wadetb/tire-sensor/README.md

# Tire Sensor

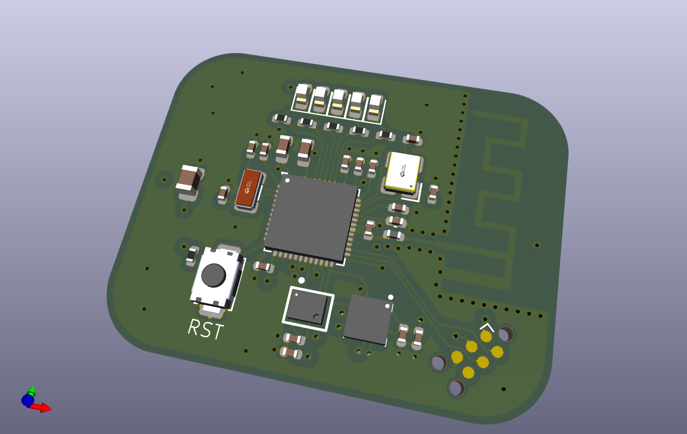
[picture p1: tire_sensor_oshpark/tire_sensor_oshpark_front.png]
Tire Sensor Front

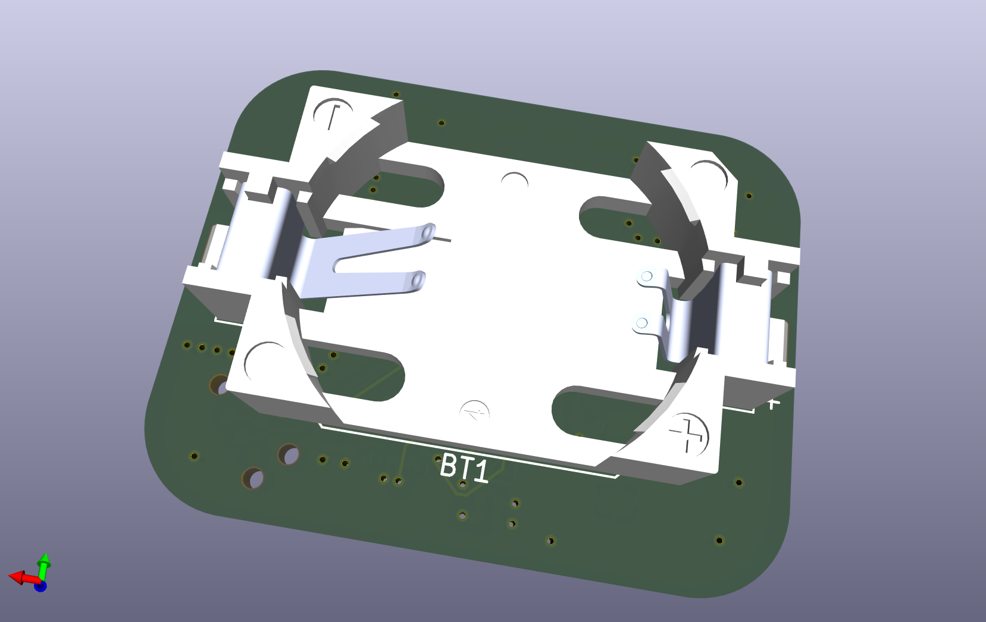
[picture p2: tire_sensor_oshpark/tire_sensor_oshpark_back.png]
Tire Sensor Back
