wadetb/tire-sensor/reference/nRF52832-QFAx Reference Layout 1_1/Bill of Materials/nRF52832-QFAA/nrf52832_qfaa_nfc_bom.xls

Bill of material
PCB: | nRF52832-QFAA Reference Layout (NFC)
Version: | 1.1
Designator | Value | Description | Footprint Doc
C1, C2, C11, C12, C13, C14 | 12pF | Capacitor, NP0, ±2% | 0402
C3 | 0.8pF | Capacitor, NP0, ±5% | 0402
C4, C5, C8 | 100nF | Capacitor, X7R, ±10% | 0402
C6 | N.C. | Not mounted | 0402
C7 | 100pF | Capacitor, NP0, ±5% | 0402
C9 | 4.7µF | Capacitor, X5R, ±10% | 0603
C10 | 1.0µF | Capacitor, X7R, ±10% | 0603
C_tune1, C_tune2 | TBD | Capacitor, NP0, ±5% | 0402
L1 | 3.9nH | High frequency chip inductor ±5% | 0402
L2 | 10µH | Chip inductor, IDC,min = 50 mA, ±20% | 0603
L3 | 15nH | High frequency chip inductor ±10% | 0402
U1 | nRF52832-QFAA | Multi-protocol Bluetooth Low Energy, ANT and 2.4GHz proprietary system-on-chip | QFN-48
X1 | 32MHz | XTAL SMD 2016, 32MHz, Cl=8pF, Total Tol: ±40ppm | XTAL_2016
X2 | 32.768kHz | XTAL SMD 3215, 32.768kHz, Cl=9pF, Total Tol: ±50ppm | XTAL_3215
