wadetb/tire-sensor/tire_sensor_oshpark/models/BAT-HLD-013-SMT-TR.step

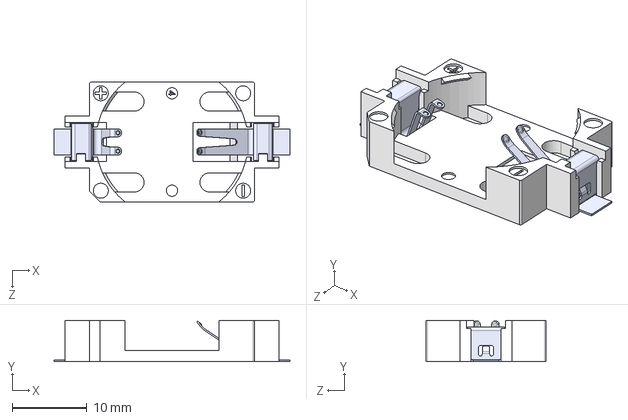
[picture p3: CAD file, 2025-07-16]
tire_sensor_oshpark/models/BAT-HLD-013-SMT-TR.step
31.5 x 5.50 x 16.0 mm
