wadetb/tire-sensor/tire_sensor_oshpark/models/LIS3DHTR.step

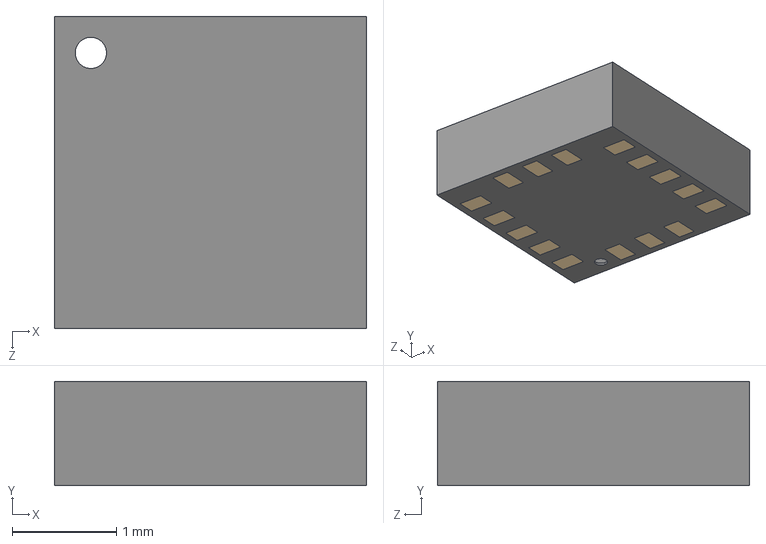
[picture p4: CAD file, 2025-07-16]
tire_sensor_oshpark/models/LIS3DHTR.step
3.00 x 1.00 x 3.00 mm
