wadetb/tire-sensor/tire_sensor_oshpark/models/DPS368XTSA1.step

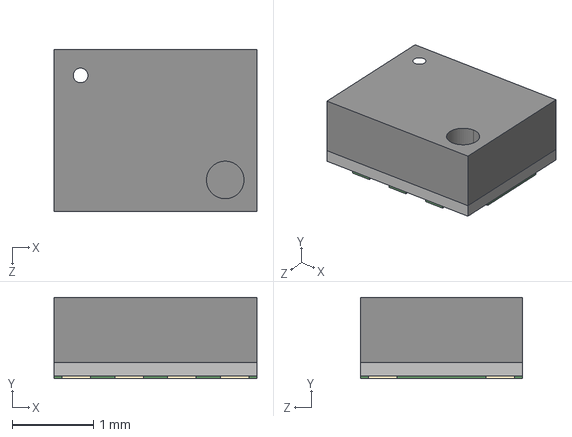
[picture p5: CAD file, 2025-07-16]
tire_sensor_oshpark/models/DPS368XTSA1.step
2.50 x 1.00 x 2.00 mm
