wadetb/tire-sensor/tire_sensor_oshpark/models/NRF52832-QFAA-R.step

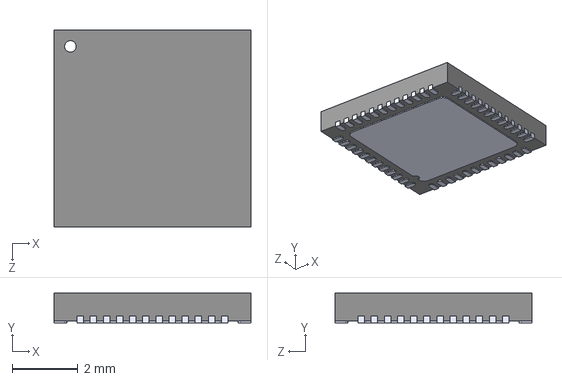
[picture p6: CAD file, 2025-07-16]
tire_sensor_oshpark/models/NRF52832-QFAA-R.step
6.00 x 0.9 x 6.00 mm
