wadetb/tire-sensor/(list of files, drawings)

Other design files:
reference/nRF52832-QFAx Reference Layout 1_1/Altium Designer files/nRF52832-QFAA/nrf52832_qfaa.PrjPCB
reference/nRF52832-QFAx Reference Layout 1_1/Altium Designer files/nRF52832-QFAA/nrf52832_qfaa.SchDoc
reference/nRF52832-QFAx Reference Layout 1_1/Altium Designer files/nRF52832-QFAA/nrf52832_qfaa_dcdc.PrjPCB
reference/nRF52832-QFAx Reference Layout 1_1/Altium Designer files/nRF52832-QFAA/nrf52832_qfaa_dcdc.SchDoc
reference/nRF52832-QFAx Reference Layout 1_1/Altium Designer files/nRF52832-QFAA/nrf52832_qfaa_nfc.PrjPCB
reference/nRF52832-QFAx Reference Layout 1_1/Altium Designer files/nRF52832-QFAA/nrf52832_qfaa_nfc.SchDoc
reference/nRF52832-QFAx Reference Layout 1_1/Altium Designer files/nRF52832-QFAA/nrf52832_qfax.PcbDoc
reference/nRF52832-QFAx Reference Layout 1_1/Altium Designer files/nRF52832-QFAA/nrf52832_qfax_dcdc.PcbDoc
reference/nRF52832-QFAx Reference Layout 1_1/Altium Designer files/nRF52832-QFAA/nrf52832_qfax_nfc.PcbDoc
reference/nRF52832-QFAx Reference Layout 1_1/Altium Designer files/nRF52832-QFAB/nrf52832_qfab.PrjPCB
reference/nRF52832-QFAx Reference Layout 1_1/Altium Designer files/nRF52832-QFAB/nrf52832_qfab.SchDoc
reference/nRF52832-QFAx Reference Layout 1_1/Altium Designer files/nRF52832-QFAB/nrf52832_qfab_dcdc.PrjPCB
reference/nRF52832-QFAx Reference Layout 1_1/Altium Designer files/nRF52832-QFAB/nrf52832_qfab_dcdc.SchDoc
reference/nRF52832-QFAx Reference Layout 1_1/Altium Designer files/nRF52832-QFAB/nrf52832_qfab_nfc.PrjPCB
reference/nRF52832-QFAx Reference Layout 1_1/Altium Designer files/nRF52832-QFAB/nrf52832_qfab_nfc.SchDoc
reference/nRF52832-QFAx Reference Layout 1_1/Altium Designer files/nRF52832-QFAB/nrf52832_qfax.PcbDoc
reference/nRF52832-QFAx Reference Layout 1_1/Altium Designer files/nRF52832-QFAB/nrf52832_qfax_dcdc.PcbDoc
reference/nRF52832-QFAx Reference Layout 1_1/Altium Designer files/nRF52832-QFAB/nrf52832_qfax_nfc.PcbDoc
