wadetb/tire-sensor/tire_sensor_jlcpcb/tire_sensor_jlcpcb.kicad_pcb

## KiCad design tire_sensor_jlcpcb/tire_sensor_jlcpcb.kicad_pcb (2026-01-19)

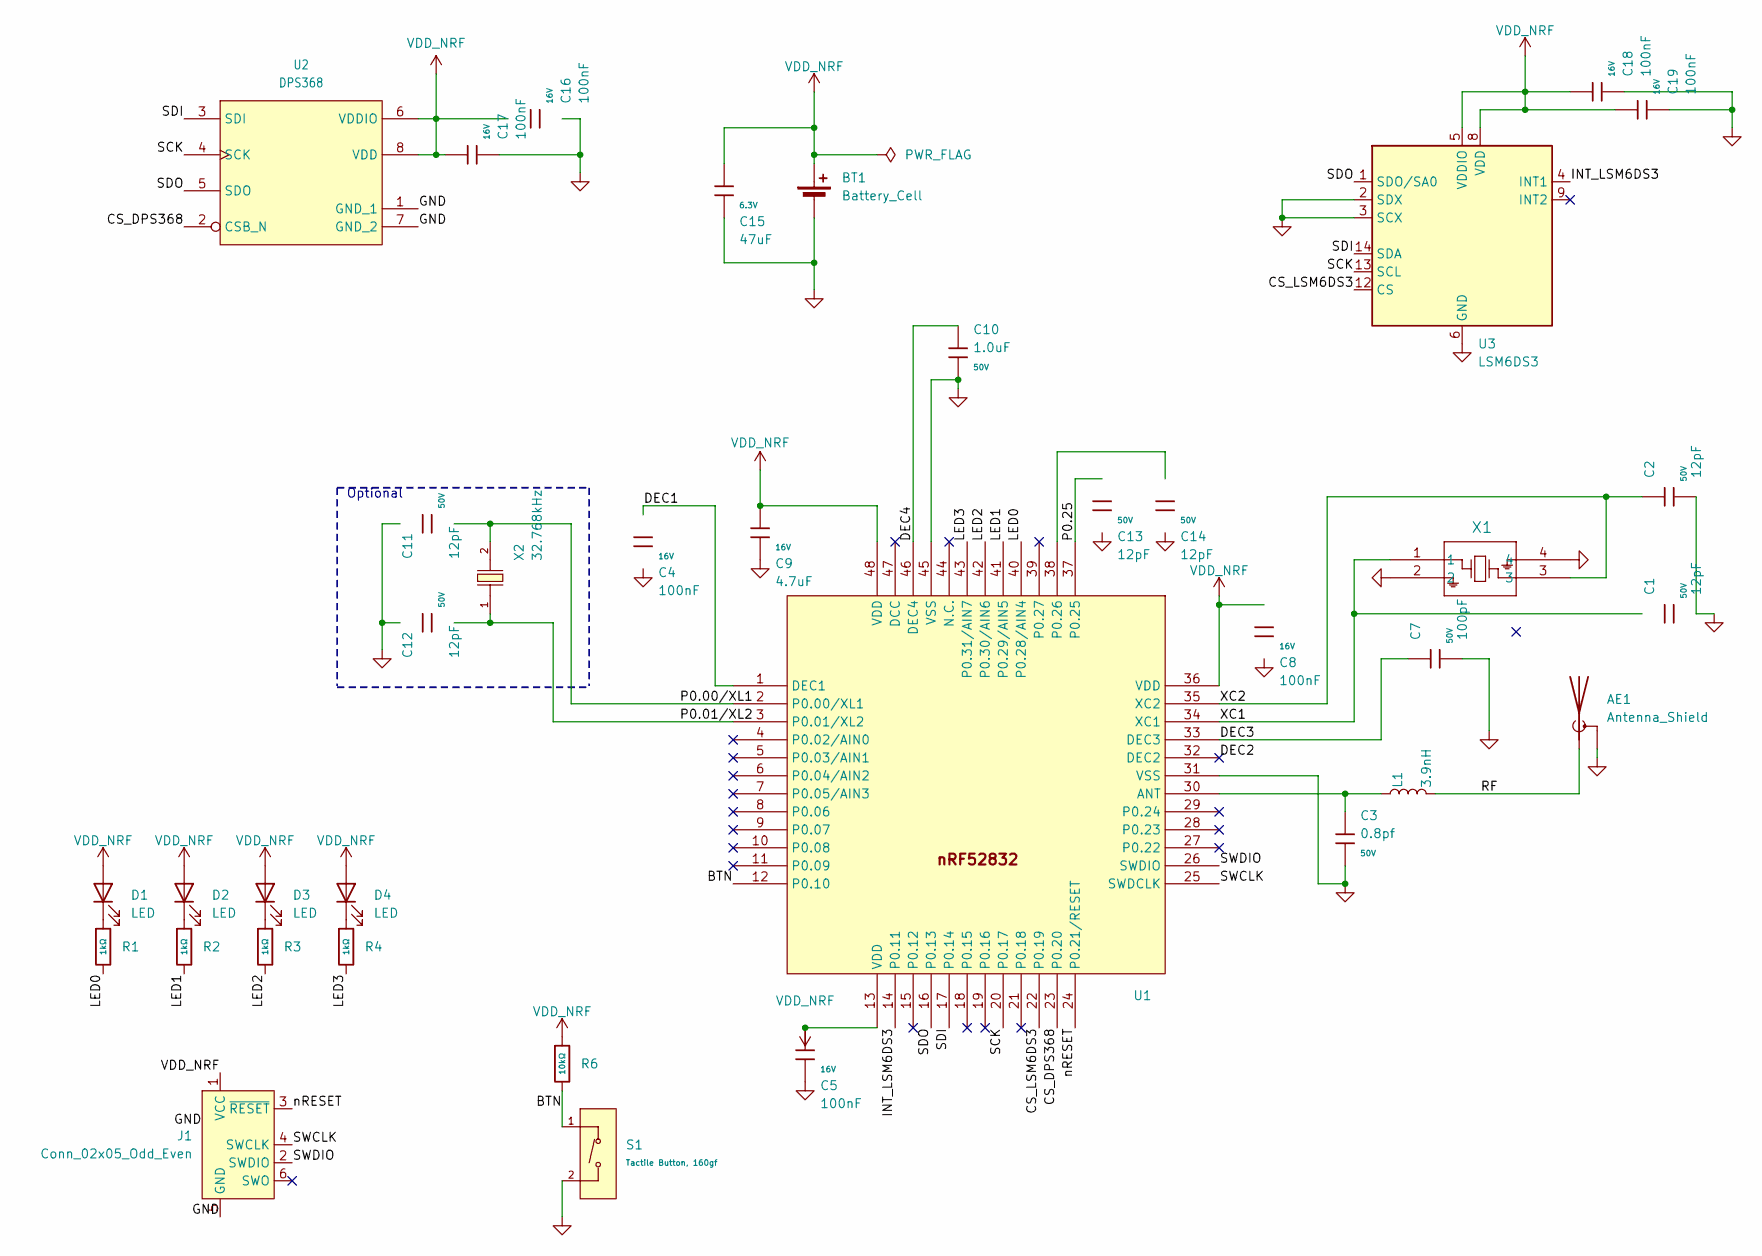
[picture p7: schematic tire_sensor_jlcpcb.kicad_sch, Tire Sensor]

Parts:
AE1: Antenna_Shield; Texas_SWRA117D_2.4GHz_Left
BT1: Battery_Cell; BatteryHolder_Renata_SMTU2032-LF_1x2032
C1, C2, C11, C12, C13, C14: 12pF; C_0402; Voltage Rated 50V; Tolerance ±5%; PART NUMBER C0402-12p; LCSC C1547
C3: 0.8pf; C_0402; Voltage Rated 50V; PART NUMBER C0402-0.8p; LCSC C1550
C4, C5, C8: 100nF; C_0402; Voltage Rated 16V; Tolerance ±10%; PART NUMBER C0402-100n; LCSC C1525
C7: 100pF; C_0402; Voltage Rated 50V; Tolerance ±5%; PART NUMBER C0402-100p; LCSC C1546
C9: 4.7uF; C_0603; Voltage Rated 16V; Tolerance ±10%; PART NUMBER C0603-4µ7; LCSC C19666
C10: 1.0uF; C_0603; Voltage Rated 50V; Tolerance ±10%; PART NUMBER C0603-1µ0; LCSC C15849
C15: 47uF; C_0805; Voltage Rated 6.3V; Tolerance ±20%; PART NUMBER C0402-12p; LCSC C16780
C16, C17, C19: 100nF; C_0402; Voltage Rated 16V; Tolerance ±10%; PART NUMBER C0402-12p; LCSC C1525
C18: 100nF; C_0402; Tolerance ±10%; Rated Voltage 6.3V; PART NUMBER C0402-12p; LCSC C1525
D1, D2, D3, D4: LED; LED_0603_1608Metric
J1: Conn_02x05_Odd_Even; Tag-Connect_TC2030-IDC-NL_2x03_P1.27mm_Vertical
L1: 3.9nH; L_0402; PART NUMBER L0402-3n9; LCSC C14033
R1, R2, R3, R4: 1kΩ; R_0402; Overload Voltage (Max) 50V; Tolerance ±1%; Part 0402WGF1001TCE; LCSC C11702
R6: 10kΩ; R_0402; Overload Voltage (Max) 50V; Tolerance ±1%; Part 0402WGF1002TCE; LCSC C25744
S1: Tactile Button, 160gf; SW_TS-1088-AR02016; Voltage Rating (Dc) 12V; Part TS-1088-AR02016; LCSC C720477
U1: QFN-48-1EP_6x6mm_P0.4mm_EP4.6x4.6mm_ThermalVias; PART NUMBER nRF52832-QFAA
U2: DPS368; LGA8S145X65P2X4_200X250X110-V
U3: LSM6DS3; LGA-14_3x2.5mm_P0.5mm_LayoutBorder3x4y; PARTREV 2
X1: NX2016SA-32MHZ-EXS00A-CS06654; FA-128_EPS
X2: 32.768kHz; FC-135R_L3.2-W1.5; Frequency Tolerance ±20ppm; PART NUMBER XTAL_SMD3215_32.768kHz_9pF_General; LCSC C32346

Connections:
/BTN: R6.2, S1.1 (A), U1.12 (P0.10)
/CS_DPS368: U1.23 (P0.20), U2.2 (CSB_N)
/CS_LSM6DS3: U1.22 (P0.19), U3.12 (CS)
/DEC1: C4.1, U1.1 (DEC1)
/DEC2: U1.32 (DEC2)
/DEC3: C7.1, U1.33 (DEC3)
/DEC4: C10.1, U1.46 (DEC4)
/INT_LSM6DS3: U1.14 (P0.11), U3.4 (INT1)
/LED0: R1.2, U1.40 (P0.28/AIN4)
/LED1: R2.2, U1.41 (P0.29/AIN5)
/LED2: R3.2, U1.42 (P0.30/AIN6)
/LED3: R4.2, U1.43 (P0.31/AIN7)
/P0.00/XL1: C11.2, U1.2 (P0.00/XL1), X2.2
/P0.01/XL2: C12.2, U1.3 (P0.01/XL2), X2.1
/P0.25: C13.1, U1.37 (P0.25)
/RF: AE1.1 (A), L1.2
/SCK: U1.20 (P0.17), U2.4 (SCK), U3.13 (SCL)
/SDI: U1.17 (P0.14), U2.3 (SDI), U3.14 (SDA)
/SDO: U1.16 (P0.13), U2.5 (SDO), U3.1 (SDO/SA0)
/SWCLK: J1.4 (SWCLK), U1.25 (SWDCLK)
/SWDIO: J1.2 (SWDIO), U1.26 (SWDIO)
/XC1: C1.1, U1.34 (XC1), X1.1
/XC2: C2.1, U1.35 (XC2), X1.3
/nRESET: J1.3 (~RESET), U1.24 (P0.21/RESET)
GND: AE1.2 (Shield), BT1.2 (-), C1.2, C2.2, C3.2, C4.2, C5.2, C7.2, C8.2, C9.2, C10.2, C11.1, C12.1, C13.2, C14.2, C15.2, C16.2, C17.2, C18.2, C19.2, J1.5 (GND), S1.2 (B), U1.31 (VSS), U1.45 (VSS), U1.49 (GND), U2.1 (GND_1), U2.7 (GND_2), U3.2 (SDX), U3.3 (SCX), U3.6 (GND), U3.7 (GND), X1.2, X1.4
unnamed: D1.1 (K), R1.1
unnamed: D2.1 (K), R2.1
unnamed: D3.1 (K), R3.1
unnamed: D4.1 (K), R4.1
unnamed: C3.1, L1.1, U1.30 (ANT)
unnamed: C14.1, U1.38 (P0.26)
VDD_NRF: BT1.1 (+), C5.1, C8.1, C9.1, C15.1, C16.1, C17.1, C18.1, C19.1, D1.2 (A), D2.2 (A), D3.2 (A), D4.2 (A), J1.1 (VCC), R6.1, U1.13 (VDD), U1.36 (VDD), U1.48 (VDD), U2.6 (VDDIO), U2.8 (VDD), U3.5 (VDDIO), U3.8 (VDD)

Notes on the sheet:
Optional

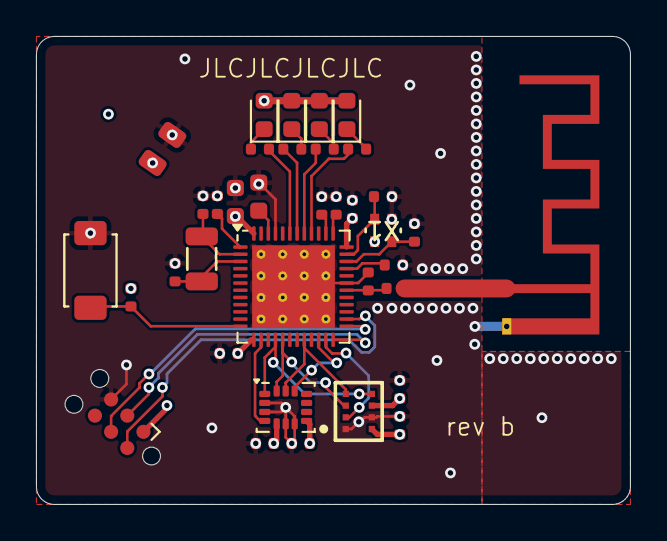
[picture p8: board tire_sensor_jlcpcb.kicad_pcb from above]

Board: 4 copper layers, 33.0 x 26.0 mm, 37 parts (1 on the bottom side), 31 nets.
