wadetb/tire-sensor/(commit log)

2025-07-10 Initial commit - basic routing and JLCPCB setup but not final
    [BOM-tire_sensor.csv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]
2025-07-10 Move ground plane to In1.Cu for RF
    [tire_sensor.kicad_pcb]
2025-07-10 Update JLCPCB part assignments
    [BOM-tire_sensor.csv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]
2025-07-10 JCLPCB updated Crystal per stock, other fixes
    [BOM-tire_sensor.csv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]
2025-07-11 No uFL, LEDs, button
    [BOM-tire_sensor.csv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]
2025-07-11 PCB tweaks
    [tire_sensor.kicad_pcb]
2025-07-11 Schematic saved
    [tire_sensor.kicad_sch]
2025-07-15 Add OSHPark version, wider spacing
    [BOM-tire_sensor.csv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]
2025-07-15 Fix VDD decoupling, reference docs
    [nrf52832_qfaa.DRL, nrf52832_qfaa.GBL, nrf52832_qfaa.GBO, nrf52832_qfaa.GBP, nrf52832_qfaa.GBS, nrf52832_qfaa.GM1, nrf52832_qfaa.GTL, nrf52832_qfaa.GTO]
2025-07-16 Models, better decoupling
    [DPS368XTSA1.step, LIS3DHTR.step, NRF52832-QFAA-R.step, tire_sensor_oshpark.kicad_pcb]
2025-07-16 Add images
    [BAT-HLD-013-SMT-TR.step, tire_sensor_oshpark.kicad_pcb]
2025-08-22 JLCPCB order W2025082300401265
    [BOM-tire_sensor_jlcpcb.csv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]
2025-08-22 Better routing and decoupling, reomved unused cap
    [tire_sensor_jlcpcb.kicad_pcb, tire_sensor_jlcpcb.kicad_sch]
2025-08-22 Added extra GND trace
    [tire_sensor_jlcpcb.kicad_pcb]
2025-08-23 Add gyro, reroute sensors
    [BOM-tire_sensor_jlcpcb.csv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]
2025-11-13 JLCPCB order W2025111310437228
    [BOM-tire_sensor_jlcpcb.csv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]
2025-11-16 RF trace fixes from DevZone
    [tire_sensor_jlcpcb.kicad_pcb]
2025-11-16 RF antenna tweaks
    [CPL-tire_sensor_jlcpcb.csv, tire_sensor_jlcpcb-CuBottom.gbr, tire_sensor_jlcpcb-CuIn1.gbr, tire_sensor_jlcpcb-CuIn2.gbr, tire_sensor_jlcpcb-CuTop.gbr, tire_sensor_jlcpcb-EdgeCuts.gbr, tire_sensor_jlcpcb-MaskBottom.gbr, tire_sensor_jlcpcb-MaskTop.gbr]
2025-11-16 Move via
    [tire_sensor_jlcpcb-CuBottom.gbr, tire_sensor_jlcpcb-CuIn1.gbr, tire_sensor_jlcpcb-CuIn2.gbr, tire_sensor_jlcpcb-CuTop.gbr, tire_sensor_jlcpcb-EdgeCuts.gbr, tire_sensor_jlcpcb-MaskBottom.gbr, tire_sensor_jlcpcb-MaskTop.gbr, tire_sensor_jlcpcb-NPTH.drl]
2026-01-19 Swap crystal to FA-128 and regen fab outputs
    [BOM-tire_sensor_jlcpcb.csv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]
